c0pperdragon/OS816/doc/breadboard.jpg

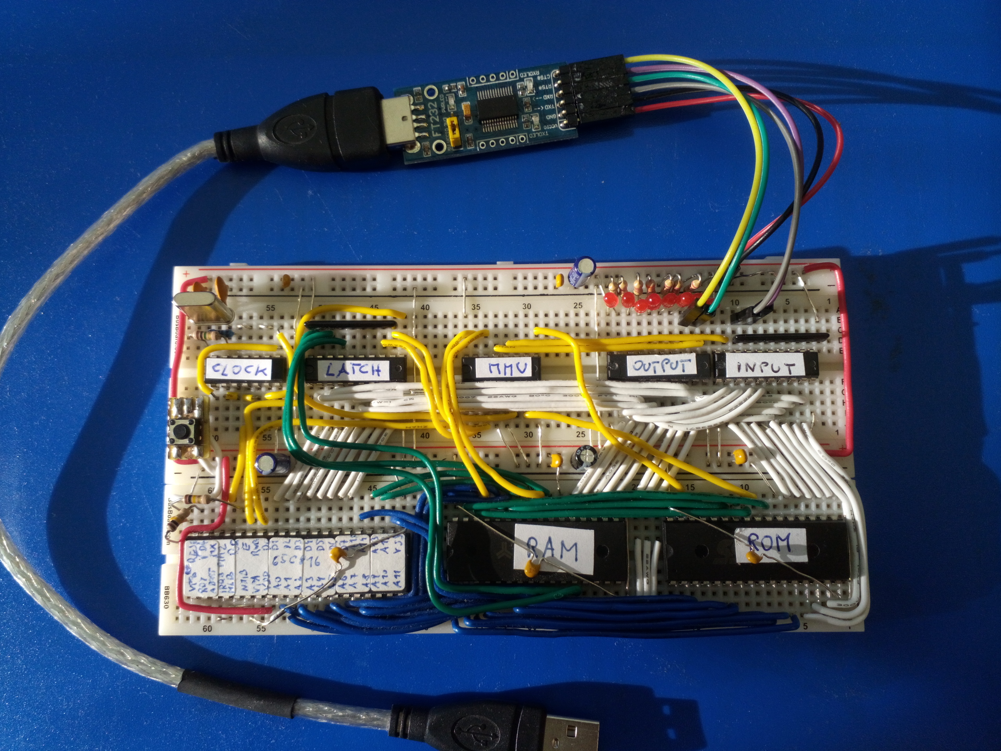
doc/breadboard.jpg
