c0pperdragon/OS816/(threads)

Thread 1 (2022-02-18):

Feature queries: VIA and strobes

gadyke, 2022-02-18:
Really impressed by the approach on this board and how elegant the approach to the limitations/quirks of the chip are. I had a couple of thoughts on apparently missing pieces that I'd welcome thoughts on:

- The design exposes input and output discrete from one another, which makes readback on e.g. a primarily write-only device with a status register. I could probably work around that with a bit of logic to prevent a bus clash (perhaps an input select register?)
- The bus pins don't expose any of the r/w strobes, which makes working with external chips that depend on a data valid/write strobe (or for that matter chip select) more challenging. I could probably break the basic i/owr signal out myself in a fork but it'd good to know if there's a fundamental barrier to that you'd previously considered.
- This in turn doesn't help with external chips that have multiple registers (e.g. 8 bit sound chips) as we don't expose any "address" pins and arbitrary i/o memory mapping would seem quite a headache. So my final question is whether mapping in a 6522 (VIA) to help expand the data/address capabilities would be fundamentally incompatible?

Very happy to be kept honest on all of this!

Thanks,

Greg

c0pperdragon, 2022-02-18:
It seems that you are extremely lucky in this respect.
The OS816 memory space is divided into 4 parts that are addressed by the address bits A23 and A22:
00 = RAM
01 = I/O
10 = unused
11 = FLASH

With the 3rd block unused (addresses 80000 - BFFFF), you can easily map the VIA chip into this range.
Even better, the VIA has two chip select lines which you can directly connect to A23 and A22 to properly select the chip.
As the VIA is specifically designed to work with the signals from the 65c02 and 65c816, you only need to wire up the clock and the RWB signal directly.

When you want to use an existing OS816 board, you will need to tap into the address and data bus and the control signals as well. Unluckily, there is no single chip that has all signals (even the CPU does not provide A23 and A23, as these are outputs of the latch). Your best  approuch would be to solder wires to the underside of the relevant sockets.

When you design your own board, or use a breadboard, you are of course completey free.

HeathenUK, 2022-02-20:
(Apologies for the confusion, switching out of the other account which is otherwise inactive)

Thanks for getting back to me.

I'm looking to adapt your design for my own PCB so as you say wiring to the A22/23 decoded signals is no trouble.

I'm pondering the fact that I don't need to use the '138 in order to add the VIA to the design (since, as you say, it understands the RWB signal just fine) and then adding on my thought above about adding at least one other built-in peripheral to the design (which will need a write strobe), do you see any flaw in:

1. Rather than wiring the VIA up to the A22/A23, wiring its CE pins to two of the unused A19/A20/A21 pins. As before, relying on the RWB signal direct from the 816; and
2. Instead and in addition to wiring the VIA to the unused address pins, using the spare A22/A23 decode on the '138 to add a new read/write strobe combo hooked up to the peripheral IC (which would then be addressable at 0x800000 as above).

I don't see how there could be a problem with (2), but I'm trying to work through in my mind whether under (1) the VIA would clash with the '138 decode logic for the RAM since the RAM rd/wr strobes would (I think) fire during any read/write to the lower address bits as this would leave A23/22 at 0/0.

Thanks again,

Greg

c0pperdragon, 2022-02-20:
You are quite right. Approach 1 would definitely cause a bus conflict with the RAM on any read access.

When you already use a VIA, you will probably not need the simple I/O circuit anyway, so the address space at 40000 is then free for your additional peripherial.
With this proper (read: expensive) solution you could even start to utilize interrupts.

HeathenUK, 2022-02-20:
Thanks for running the thought experiment with me!

I have a couple of follow-up thoughts if you don't mind:

1. I assume there's no issue with tying the same clock to the VIA as the 816? I'm still getting my head around the A16-23/Data multiplexing and exactly when different states will be valid at different points in the instruction cycles. I think it's probably fine as the '573 will have latched at the end of the previous cycle (via #CLK) to the one clocking the VIA (next CLK). The only thing that gives me pause is that the '138 decodes on CLKFAST.

2. Am I correct in thinking that the full range of lower address bits are available to any device strobing on A23/A22 at 1/0 (i.e. replacing the single I/O port address)? That is to say, if my peripheral exposes a few register address pins (rather than just a data bus and a write pin) there's no reason this would clash at all with RAM in the way option 1 above would have done?

And way ahead of you on interrupts! I fully intend to use the timer on the VIA so will indeed hook up IRQB (I'll leave NMI pinned high).

Regards,

Greg

c0pperdragon, 2022-02-20:
The bus timing is indeed a bit tricky with this processor.
Every clock cycle is divided into two halves. The cycle starts when the clock line goes low. There the CPU will put the high address bits on the data bus and the low address bits on the address bus (and also sets RWB according to the access type). In the second half of the cycle (clock high), the CPU will still keep the low address bits on the address buts, but will either release the data bus (for read accesses) or put the outging data there (for write accesses).

A peripherical chip that needs to work with this protocol, also has to tri-state the data bus in the first halve of the cycle even if otherwise selected for read. The VIA (at least the variant from Western Design Center) already does that. With the 138 wired up as in my design, the RW and WR strobes are also idle in the first half of the cycle, so this should work  with all parts that follow the standard RAM access protocol.

My clocking circuit generates this CLKFAST signal to have something that is approx 10ns early in respect to the cpu clock. This should about match the delay introduced by the CPU itself to tweak the performance a tiny bit. With this arrangement I can run the machine with about 14MHz quite reliably. Otherwise there is no real benefit in that.

c0pperdragon, 2022-02-21:
Maybe there is one thing to mention about latching the high address bits: The latch used here is a transparent latch. That means it will change its output signals immediately upon change of the input signals, as long as the latch enable is active. Once the latch enable goes to inactive, the output stays as it was  (maybe I have mixed up the active/inactive nomenclature here).
So contrary to an edge-triggered flip-flop the data does not have to be prepared in the previous cycle but can be delivered relatively late during the cycle.

c0pperdragon, 2022-02-26:
I really would not recommend to having overlapping address ranges. A programming error could cause a bus conflict and potential damage.

But with two MMUs, you can actually do much better:
First MMU:
  Use CLKFAST/A23/A22 as enable signals and A21/A20/RWB as output selectors.
  This gives you access to 4 R/W pairs mapped at 000000-0FFFFF, 100000-1FFFFF, 200000-2FFFFF, 300000-3FFFFF
Second MMU:
  Use CLKFAST#/A23 as enable signals (the A23 connects to the active-high enable, and you need to take CLKFAST# from U5A).
  Use A22/21/RWB as output selectors
  This gives 4 R/W pairs mapped at 800000-9FFFFF, A00000-BFFFFF, C00000-DFFFFF, E00000-FFFFFF
This leaves the area 400000-7FFFFF free so you can map in the VIA

HeathenUK, 2022-02-26:
Hmm, thanks. Can I ask a couple of questions?

- Can you explain the reasoning behind the change to clkfast# for the second MMU?

- For me the main benefit in my schema was freeing up room for an extra VIA-like device, I think this still leaves just the one unmapped range to tie a VIA into and therefore no more to map a second VIA-like device in. Have I misunderstood?

- I'm also not sure I see the address overlap I've created in that schematic - but I think that's a basic error on my part if you could point it out?

c0pperdragon, 2022-02-27:
To clarify my proposal, I just explain what the E1 - E3 inputs of the MMU are actually doing: In order for any output to be active (low), all of the enable inputs need to be in their active state. That means E1,E2 low and E3 high.
In my original OS816 i just use the active high input to enable the RD/WR signals only in the second half of the clock cycle.
I could also have used one of the other enable inputs, by feeding in the inverted CLKFAST signal. But my measurements showed that by using just the CLKFAST all signals timings matched up better.

In my proposal I would feed A23,A23 to E1,E2 and CLKFAST to E3 (as original) of the frist MMU.
The second MMU needs to be active on a high A23. As there is only one active-high enable input available I just swapped the polarity of the CLK as described above so I can use a low-active enable for this.

The address overlap in your schematic is for the range 100000-3FFFFF. Performing a read on these addresses would select both RAMRD#, as well as one of IORD#, AUDIORD, SPARERD.

c0pperdragon, 2022-02-27:
Maybe I could propose another solution that uses only one MMU but a bit of additional decoding logic.
This solution would give you 4 RD/WR pairs and also the possibility to map in some VIA-style chips.
Additionally  the memory addresses as used in the OS816 software would stay the same, so there is no need to modify it.

Starting from the original OS816 schematics, you can use some logic gates (preferable from a single chip) to create a single signal from A23,A22,A21.  This signal can be high when the address does not match one of the ranges needed by the OS816 system. Use this signal as active high CS input to the VIA-type chips (more decode logic may be necessary, depending on the IC). Also use this signal as one of the active-low enable inputs for the MMU.

For example, using a single 7400 ICs, you can combine this to NOT ((A23 NAND A22) NAND A21) . If I am correct, this would create a high signal for the ranges 200000-3FFFFF, 600000-7FFFFF, A00000-BFFFFF.

HeathenUK, 2022-02-27:
On your first response - I see! I thought there was some timing reason for using CLKFAST#, it didn't even occur to me that it was because you'd used up the active-high enables.

I think I more or less got to your reasoning in the end as I tabled out the implications for the two '138s...

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

Clearly there's room for flash etc. but the range will be completely different as you say.

Greg

HeathenUK, 2022-02-27:
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

On this second response, wouldn't this mean that each of the VIA-type devices mapped in directly would have their CE go high when any of the others was accessed? Or is the suggestion that (since most VIA-type chips have two CE pins) you would also tie a unique address pin to the other CE pin?

HeathenUK, 2022-02-27:
I've also just realised that nothing at all bars us from bumping flash and RAM up to 8mbit (other than the fact that it's overkill!) but I don't think that's unique to the dual MMU proposal.

HeathenUK, 2022-02-27:
As an aside I've just been skimming the monitor/bios code to see how involved it's going to be if I end up needing to change ranges around.

I assume I need to leave RAM at 00:0000, and also assume it's necessary (for vectors) to leave FLASH at the other end, which in this new arrangement becomes E0:0000 to FF:FFFF. For the latter I assume I need to adjust both the x_topaddress routines and the linker parameters in build.bat. Have I got that right? I'm finding the assembler/linker/librarian docs a bit obtuse!

Regards,

Greg

c0pperdragon, 2022-03-01:
Yes, it is necessary that RAM is visible at 00:0000.
FLASH indeed needs to be at the high end because my simple circuit forces the bank address to FF during emulation mode after startup. You can change this by weakly pulling some address pins low instead of high, but you would need additonal resistors instead of my simple solution with the single resistor pack.
The rest is open to rearrangement, but you may have to do changes to the code.

If you are re-arranging things anyway and use a second MMU, you could as well expand the addressing capabilties like this:
First MMU like in my prosoal for address ranges 0x:xxxx, 1x:xxxx, 2x:xxx, 3x:xxxx
Second MMU simimlar, but for the ranges Cx:xxxx, Dx:xxxx, Ex:xxxx, Fx:xxxx
This completely leaves two big ranges (400000-7FFFFF and 80000-BFFFFF) that can be used for two VIA-style components.
The only drawback is that you need to invert at least one of the address lines A23,A22 to use as enable inputs for the second MMU. If you need a 74HC04 anyway, you could as well invert both and feed the CLKFAST into E3 as usual.

I don't have the details on the linker commands in my head right now. You may need to experiment to get things right.

gadyke, 2022-03-01:
I like that, the obsessive in me prefers the evenness of having 8 1Mbyte address ranges rather than 4 1Mbyte and 4 2Mbyte!

c0pperdragon, 2022-03-01:
I just looked at the clock circuit in the OS816 schematic. Maybe you can just re-arrange the inverters a bit to free one up to invert A23. Together with the trick to use CLKFAST# instead of CLKFAST you could get away without the need for an additional 74HC04.

c0pperdragon, 2022-03-01:
Yes, U5E should not be all too important for the clock signals shape.

gadyke, 2022-03-01:
Great, this is looking more and more elegant a solution every moment!

gadyke, 2022-03-02:
Almost a philosophical question from me on the consequence of cutting out one of the existing post-crystal inverters...

Strictly speaking that would mean CLK would now be CLK#, CLKFAST will be CLKFAST# and vice versa. I suppose in practice it makes absolutely no difference - a square wave is a square wave even when it's inverted.

Basically I was wondering if I need to do any rewiring of the various uses of those signals and came to the conclusion that it's irrelevant!

Any correction on that?

Greg

c0pperdragon, 2022-03-02:
Yes, inserting/removing an inverter there makes no difference. I actually no not consider the signal from the crystal of being any  specific phase until it is used for some useful logic. From this point on, of couse you need to name the things properly.

If couse you can wire up the various gates in the logic ICs as is most convenient for you.

I myself normally adjust the use of gates during the board layout to keep things as disentangled as possible.

gadyke, 2022-03-02:
Great, I'll re-do the schema tonight before I get started on laying out a board.

G

HeathenUK, 2022-03-04:
Right, this all looks good to me - would you be willing to skim and see if anything looks obviously wrong on the MMU side?

[mainboard_MMU2.pdf](https://github.com/c0pperdragon/OS816/files/8188273/mainboard_MMU2.pdf)

That schematic is based around this mapping out:

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

I think I'll source an 8mbit SRAM just because it can fit, 8mbit parallel NOR sadly rarer 🤣

G

c0pperdragon, 2022-03-04:
Looks OK to me. With this setup you can use a RAM IC with up to 1MB, as you said. What kind of parts to you intend to use? As far as I know, there are no through-hole parts with this size available.

HeathenUK, 2022-03-04:
Thanks and you're absolutely right - I'm happy enough soldering SMD components where I won't have cause to swap them on and off so I'm using a TSOP44 part.

Leaving the flash as PLCC though!

G

c0pperdragon, 2022-03-17:
Maybe it is a little late now, but I actually found the perfect solution to add auxilary ICs to the OS816 architecture without modifying the original memory map, so there is no need to modify the BIOS:

* Start from the original OS816 schematic.
* Fully wire up the latch to the data bus (which I should have done in the first place anyway)
* Add one 74HC138 (call it MMU2)

The MMU2 has its E2/E3 connected to A23/A22 so it is active only for the free range 800000-BFFFFF
The A0-A2 inputs of the MMU2 are connected to A19-A21.
This gives you 8 chip-select (CS) outputs what will be active (low) for the 8 individual ranges 800000-87FFFF,880000-8FFFFF,...

Each CS can be used to either drive a VIA-style IC (together with system clock and RWB), or to drive a memory-style IC (together with the previously unused output pins 10 and 11 of MMU1 as its RD and WR lines)

HeathenUK, 2022-03-17:
So in this schema MMU1 gives you (as before) 8080-style ranges with a RD# and WR# for each range, while MMU2 gives you 8  "traditional" CS# pins.

The only downside I can see is that I was getting used to the idea of having 1MB of SRAM 😄

c0pperdragon, 2022-03-18:
Yes, that is right. You get 3 RW#/WR# ranges (4 MB each) and 8 ranges for the CS# pins. (512KB each).
And the 4th R/W pair generates the access signals if they are needed for any IC that sits on one of the CS# ranges. Your sound chip for example would be connected to one CS line and to these R/W as well.

gadyke, 2022-03-18:
Ok great, can I check that you actually meant E2/E3 as A22/A23 rather than A23/A22 for MMU2 if you're targeting the unusued 80:0000-BF:FFFF range (since E2 is the active low)?

Just to make sure I haven't missed something. I'll probably table it out again anyway later just to get the ranges noted down.

G

c0pperdragon, 2022-03-18:
Yes, I mixed that up. E3 (active high) gets A23 and one of E2/E1 (active low) gets A22. The remaining is just GND.

gadyke, 2022-03-18:
Ah good.

This seems perfect, and the most elegant solution so far - as you say it doesn't need any changes to the existing map (though agree with your thinking in Issue #3 that opportunities to make the ranges dynamic are sensible!)

G

HeathenUK, 2022-03-28:
Just as a coda to this discussion and in case you're curious, this is the schematic I'm currently routing: [mainboard_MMU2.pdf](https://github.com/c0pperdragon/OS816/files/8361207/mainboard_MMU2.pdf)

Thread 3 (2022-03-17):

BIOS support for more RAM

c0pperdragon, 2022-03-17:
The OS816 memory architecture allows for fairly easy extension of the RAM to up to 4MB in a modified circuitry. This can easily be done by using a larger static RAM IC.
But currently there is no direct support from the standard BIOS. There is actually a function call to query the size of the RAM, but this is currently hardcoded to just report 512K.

@gadyke @HeathenUK
If there is demand for that, I could modify the BIOS code to add some auto-detection to see how much RAM is actually installed and then report his number on the existing bios function call. This would immediately allow user programs to access more dynamic RAM via the malloc/free memory management.

gadyke, 2022-03-17:
That would be amazing!

I've actually just started to make a list of all the references/constants I will need to update to account for the new memory map and ranges (including, for example, the RAM size function call).

I was also thinking about changing some of the hard coded constants (e.g. for flash location, length) into labels/references so I can define the values at the top of the source rather than mid-file (and sometimes more than once).

Greg

gadyke, 2022-03-18:
This might be for Issue 1 where we're discussing memory maps, but when you say 4MB SRAM is supported "in a modified circuitry" do you just mean fully wiring up MMU1?

I ask because I think that in every other way you've already got a 4MB address space per-device in MMU1.

c0pperdragon, 2022-03-18:
Yes, I meant just that, as the current reference schematics does not provide A19-A21

gadyke, 2022-03-18:
Ah right, understood! Apologies for any confusion, I responded above to your original thought.

c0pperdragon, 2022-03-18:
I have just uploaded a new revision of the main board sematics and layout + gerbers. It was actually embarasingly easy to add the traces to the PCB layout. I really don't know why I left them out in revision 3.
This now makes the board much more "hackable" if anyone wants to solder additional parts to it.

c0pperdragon, 2022-03-19:
The modifications to the bios are done and available in the github releases section.
Autodetection will work for RAM sizes of 512KB, 1MB, 2MB, 4MB.  The detection algorithm assumes that the RAM is always visible in the whole range of 000000 - 3FFFFF. With ICs smaller than 4MB, the same memory locations are visible in the usual repeating pattern.

gadyke, 2022-03-21:
This is just about related, but I've been thinking about how I intend to lay out the RAM for the board and although 32Mbit SRAM does exist it's expensive (and always SMD, not that that's an issue).

I don't see any design reason why I can't just decode A20 and A21 (either via a '138 with a fixed input or a '139) and spread the RAM over 4 much cheaper 8Mbit chips (using the decoded address as a RAM chip-specific CS#), relying on the pre-existing RAMRD# and RAMWR# signals.

It seems a pretty standard design choice (it's what Sergey did with the Omega), but please do scream if there's some OS816-specific reason this would be a bad idea!

G

c0pperdragon, 2022-03-22:
Using 2 ICs to get 4 MByte in total would also have been my choice.
But you probably need to invert A21 for one of the chips. You can again free up one inverter as discussed earlier.
Or maybe you can get a RAM IC that has two CS inputs (one low-active and one high-active). I remember that once I saw such an arrangement on a 64Kbyte RAM.

gadyke, 2022-03-22:
Yep that's exactly what I was thinking, most of the 2MByte ICs I've found have both a high and a low CS, including one of the bigger brother of the 1MByte IC you're already using (AS6C1608)!

And yeah if that doesn't work I can re-purpose an inverter again as you say.

G

c0pperdragon, 2022-03-22:
I did a quick check on mouser and it seems that there are no parts bigger than 1MByte that run on 5V. So if you want to have 4MB and no voltage translation (which is is real pain, actually), you need 4 ICs.
On the other hand, if you are content with 2MB this is totally easy as these ICs do have CS# and CS2 inputs.
With 4 parts, address decoding is a bit more complicated and would need at least 2 inverters for A21 and A20.

gadyke, 2022-03-22:
You're quite right - something I haven't had cause to mention is that I'm planning to run the board on 3.3V (bucked down from a 5V lipo charge/boost board) with a few components powered from the master 5V supply but all **logic** done on 3.3V.

Do shout if there's some obvious reason that wouldn't work - it all seems to be within spec for the W65c816S (I may have to keep to 10-14MHz though).

G

gadyke, 2022-03-22:
Yeah I'd be doing the same (and would stick as you say with 4 ICs for RAM decoded via a '138/139), but my grand plan is for this to become a portable device - I'm going to mount a 7" LCD to the PCB driven by an RA8876 (a chip that has roughly the same level of hardware acceleration as a contemporary VDP and plenty of VRAM).

All the I/O on that LCD driver board is 3.3v so although I could translate the voltage back to 5V it's a *lot* of lines to translate (~25) and switching to 3.3V overall opens the door to a bunch of other ICs.

G

gadyke, 2022-03-22:
I'm also hoping that if I can get my routing and decoupling right and switch to a 4 layer board I might be able to push a 3.3V version to 16MHz without too much effort, but there's a reason I'm making it possible to change out the crystal!

Thread 4 (2022-04-16):

Incorrect A14, A15 and A17?

HeathenUK, 2022-04-16:
I was just glancing at your original schematic and PCB routing when sense checking my own design and realised that you seem to have A15 wired to A17, A17 to A14 and A15 to A14. As far as I understand the design this shouldn't be intentional but equally may not have shown up given how high up the RAM addresses it occurs?

c0pperdragon, 2022-04-16:
I changed the wiring to get a simpler board layout. When you think about it, it makes absolutely no difference how you wire up the address pins on a static ram.Same holds true for the data pins.

HeathenUK, 2022-04-16:
I did wonder about that, I guess you're right as long as it's consistent throughout runtime - it feels like sacrilege though!

Closed 2022-04-16.
