c0pperdragon/OS816/ramboard/ramboard.pdf

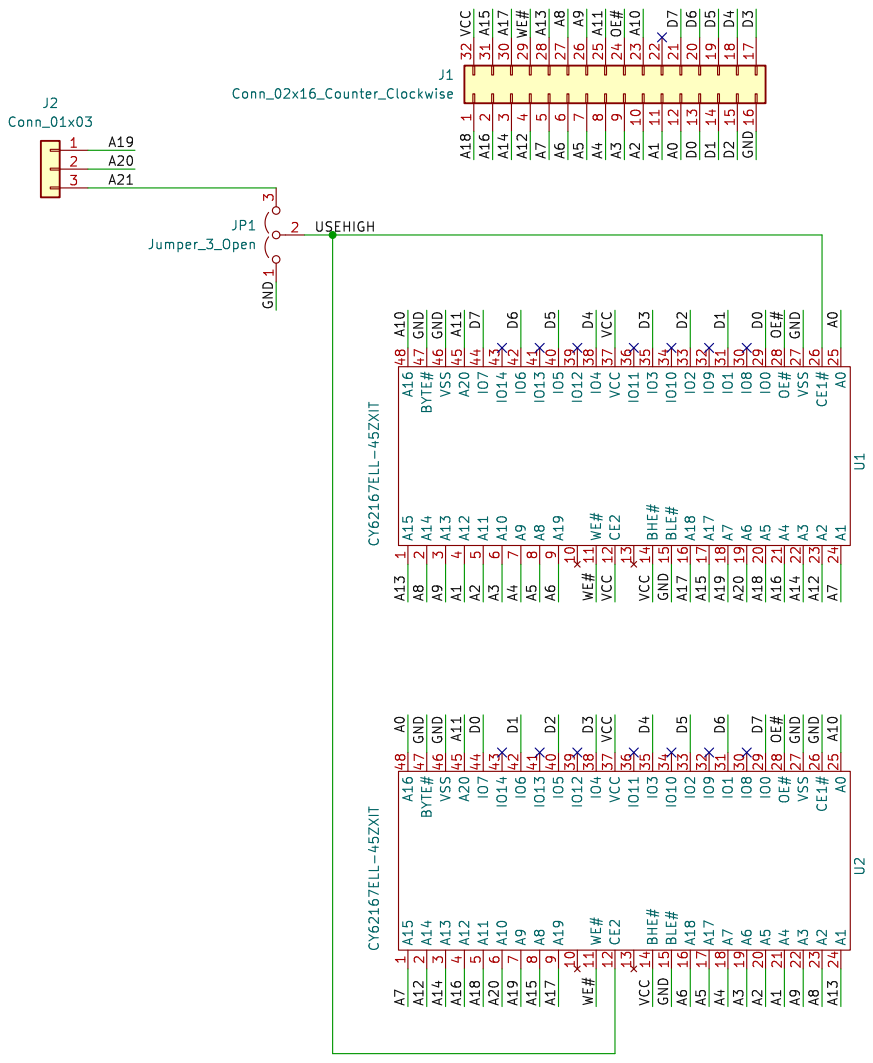
[picture p60: page 1]

Id: 1/1 Title: OS816 RAM board
