c0pperdragon/OS816/mainboard/mainboard.pdf

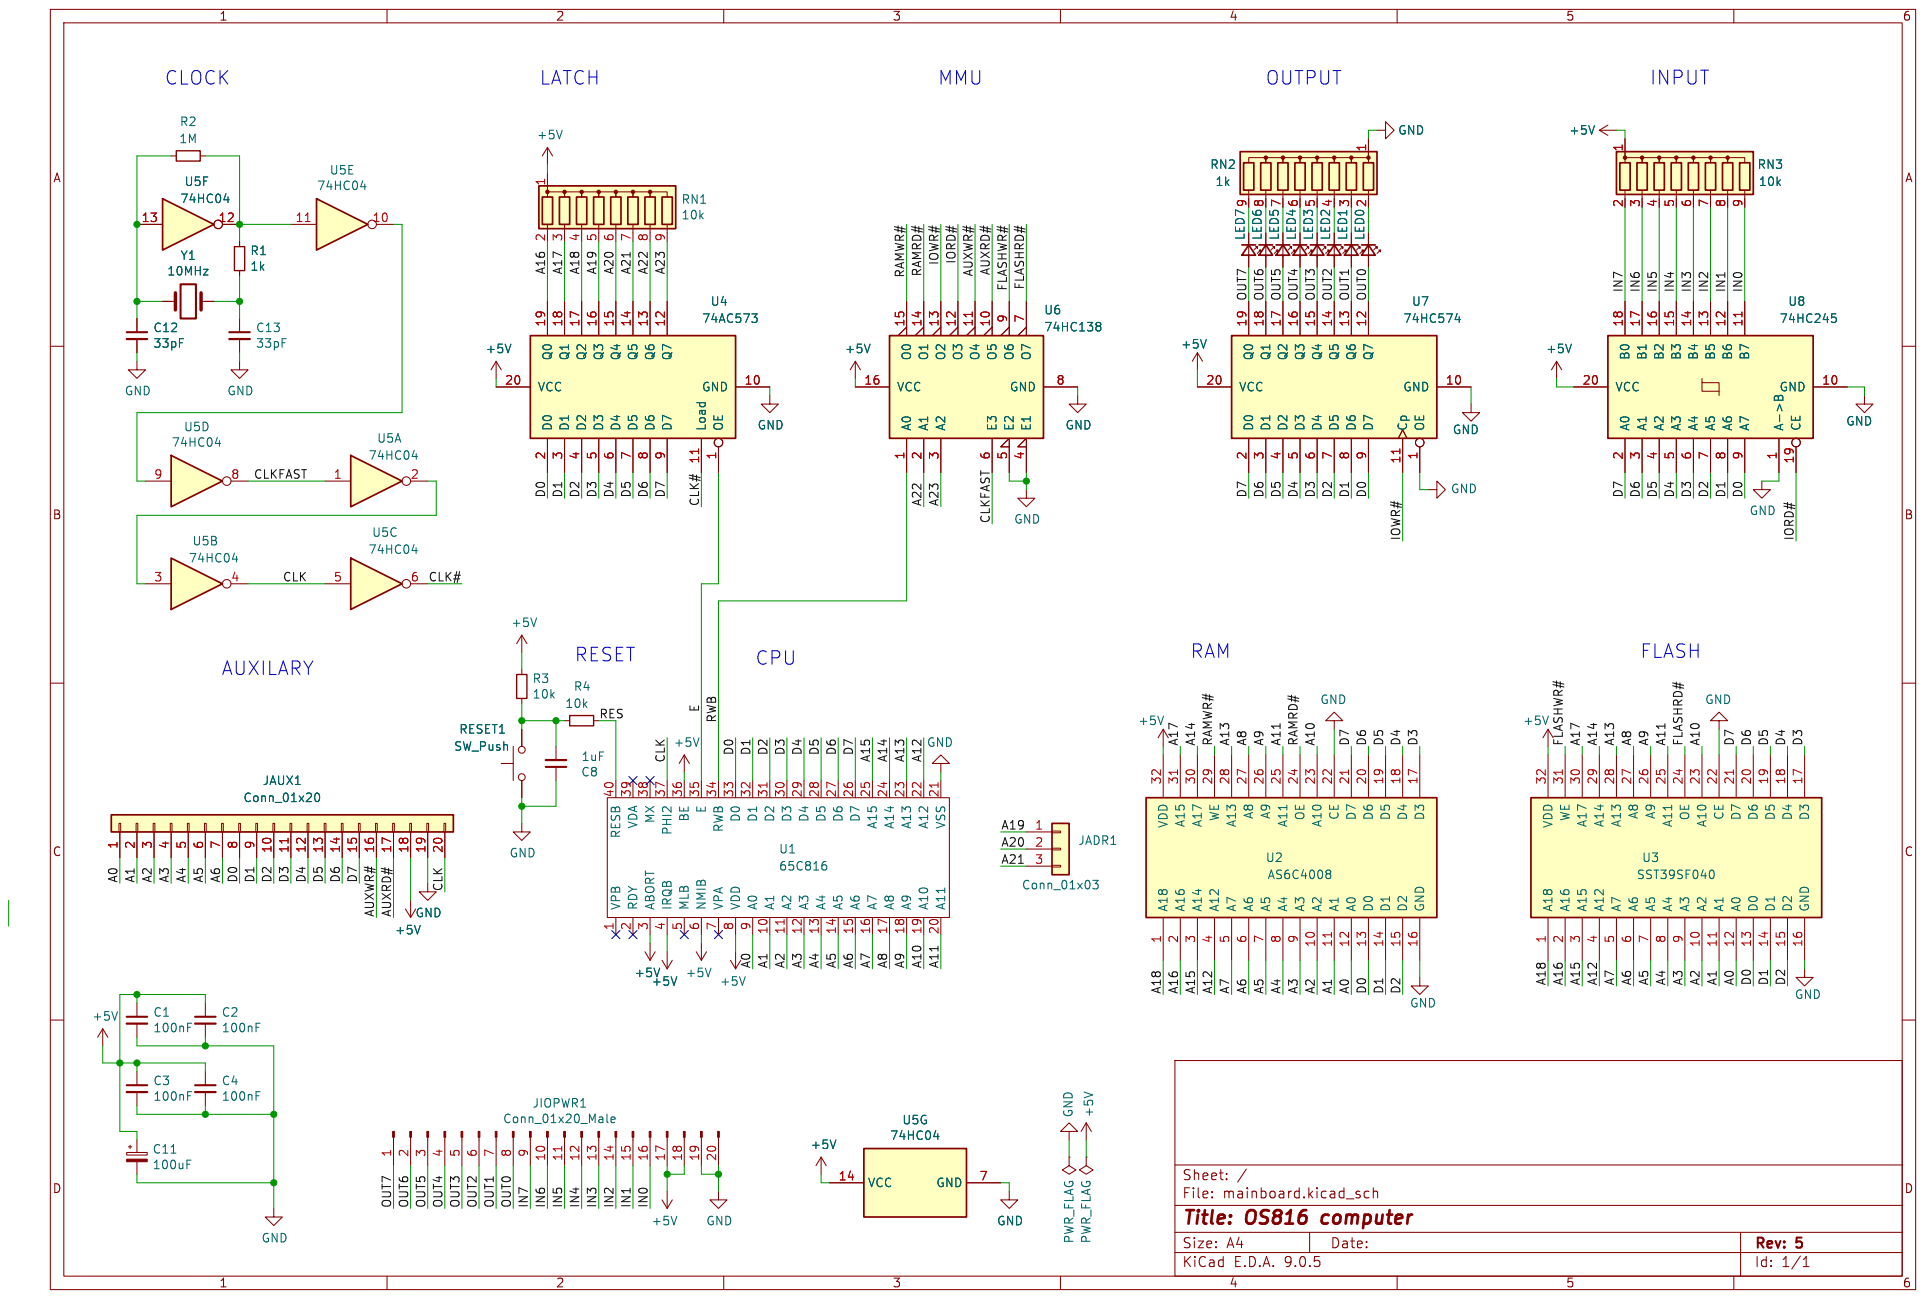
[picture p61: page 1]

9 A2 10 A1 11 A0 12 D0 13 D1 14 D2 15 GND 16 VDD 32 WE 31 A17 30 A14 29 A13 28 A8 27 A9 26 A11 25 OE 24 A10 23 CE 22 D7 21 D6 20 D5 19 D4 18 D3 17 U3 SST39SF040 C4
JAUX1 Conn_01x20

9 A1 10 A2 11 A3 12 A4 13 A5 14 A6 15 A7 16 A8 17 A9 18 A10 19 A11 20 RESB 40 VDA 39 MX 38 PHI2 37 BE 36 E 35 RWB 34 D0 33 D1 32 D2 31 D3 30 D4 29 D5 28 D6 27 D7 26 A15 25 A14 24 A13 23 A12 22 VSS 21 U1

9 A2 10 A1 11 A0 12 D0 13 D1 14 D2 15 GND 16 VDD 32 A15 31 A17 30 WE 29 A13 28 A8 27 A9 26 A11 25 OE 24 A10 23 CE 22 D7 21 D6 20 D5 19 D4 18 D3 17 U2AS6C4008 VCC 14 GND 7 U5G
