c0pperdragon/OS816/src/os816.asm

    ; external references
    XREF _ROM_BEG_DATA
    XREF _BEG_DATA
    XREF _END_DATA
    XREF _BEG_UDATA
    XREF _END_UDATA
    XREF ~~main
	
    ; linking to bootloader code
    xdef ~~softreset
    xdef ~~sleep
    xdef ~~send
    xdef ~~receive
	xdef ~~sendstr
    xdef ~~writeflash
    xdef ~~eraseflash
    xdef ~~topaddress_flash
    xdef ~~topaddress_ram
    xdef ~~sendnum
    xdef ~~portout
    xdef ~~portin
~~softreset        set $FFF000
~~sleep            set $FFF003
~~send             set $FFF006
~~receive          set $FFF009
~~sendstr          set $FFF00C
~~writeflash       set $FFF00F
~~eraseflash       set $FFF012
~~topaddress_flash set $FFF015
~~topaddress_ram   set $FFF018
~~sendnum          set $FFF01B
~~portout          set $FFF01E
~~portin           set $FFF021

    ; start vector on fixed address        
LAUNCH SECTION
    ORG $C00000
    JMP >startmain
    ENDS
        
    ; startup code already in CODE segment
    CODE
startmain:
    LONGA ON
    LONGI ON

    ; clear UDATA segment
    LDA #_END_UDATA-_BEG_UDATA ; number of bytes to clear
    BEQ noclear    
    SEP #$20     ; for 8-bit memory access
    LONGA OFF
    LDA #0
    STA >_BEG_UDATA
    REP #$20  
    LONGA ON
    LDA #_END_UDATA-_BEG_UDATA-1 ; number of bytes to replicate
    BEQ noclear
    LDX #<_BEG_UDATA  
    TXY   ; set up copy instruction for forward replication
    INY
    DEA  
    MVN #^_BEG_UDATA,#^_BEG_UDATA
noclear:

    ; Copy initial content into DATA segment. 
    ; Also the Data Bank Register will be correctly set to this bank  
    ; by the MVN instruction    
    LDA #_END_DATA-_BEG_DATA ;number of bytes to copy
    BEQ nocopy
    DEC A ;less one for MVN instruction
    LDX #<_ROM_BEG_DATA ;get source into X
    LDY #<_BEG_DATA ;get dest into Y
    MVN #^_ROM_BEG_DATA,#^_BEG_DATA ;copy bytes
nocopy:

    ; to work around in a bug in the sprintf function, leave a portion 
    ; of the stack unused 
    TSC
    SEC
    SBC #768
    TCS
	
    ; start the main function
    PEA #^argv
    PEA #<argv    
    PEA #1
    JSL >~~main
    
    ; do proper exit handling
    PHA
    JSL ~~_exit

progname:
    DB "OS816"
    DB 0
argv:
    DW #<progname
    DW #^progname
    DW 0
    DW 0
    ENDS 


    xdef ~~_exit    
    CODE
~~_exit:
; ------------------ RESTART or SHUTDOWN --------------------
; Let the machine restart or stop entirely 
; This depends on the exit-value. All negative values will cause a complete stop. 
    ; initial stack layout:  
    ;   SP+1, SP+2, SP+3    return address
    ;   SP+4, SP+5          return value from main() or exit()
    LDA <4,S
    BPL wantreset
    STP
wantreset:
    JMP >~~softreset    
    ENDS
	
    
    END
