c0pperdragon/OS816/src/boot.asm

; -------------- interface with boot monitor program ------------
    XREF ~~monitor
    XDEF ~~send
    XDEF ~~receive
    XDEF ~~sendstr
    XDEF ~~writeflash
    XDEF ~~eraseflash
    
    
; --------------------- RAM layout ---------------------------- 
stacktop            set $00FEFF   ; right below the reserved 256 bytes
buffereddata        set $00FF00   ; 252 bytes
numbuffered         set $00FFFC   ; 8 bit
numconsumed         set $00FFFD   ; 8 bit
outportshadow       set $00FFFE   ; 8 bit
detectedrambanks    set $00FFFF   ; 8 bit

; The timeouts for waiting for incomming data after asserting RTS and then also after
; de-asserting the line again. 
; For true 65c816:
;    One timeout unit is 17 clocks, so a receive function call will
;    cause an idle delay of about 500 microseconds.
timeout1             set 194
timeout2             set 100
; For Bernd emulation use same values, even if the timeout would be higher than necessary

BOOT SECTION        ; needs to be located at $FFF000
    LONGA ON
    LONGI ON
    
; ------------ JUMP TABLE INTO THE BOOT LOADER ROUTINES ---------    
    JMP ~~softreset            ; FFF000
    JMP ~~sleep                ; FFF003
    JMP ~~send                 ; FFF006 
    JMP ~~receive              ; FFF009
    JMP ~~sendstr              ; FFF00C 
    JMP ~~writeflash           ; FFF00F
    JMP ~~eraseflash           ; FFF012
    JMP ~~topaddress_flash     ; FFF015
    JMP ~~topaddress_ram       ; FFF018
    JMP ~~sendnum              ; FFF01B
    JMP ~~portout              ; FFF01E
    JMP ~~portin               ; FFF021

; -------------------- STARTUP -------------------------------
~~softreset
    ; 16-bit mode for accu and index registers
    ; clear all other status flags as well
    REP #$FF   
   
    SEP #$20 
    LONGA OFF
    ; detect number of RAM banks
    LDA #64        ; possibly 4MB
    STA >$3FFFFF
    LDA #32        ; possibly 2MB
    STA >$1FFFFF
    LDA #16        ; possibly 1MB
    STA >$0FFFFF
    LDA #8         ; possibly 512KB
    STA >$07FFFF   
    LDA >$3FFFFF   ; read out result of detection
    STA >detectedrambanks
    ; set the output port to a defined state
    LDA #$FF
    STA >$400000
    STA >outportshadow
    REP #$20 
    LONGA ON
            
    ; initial stack pointer
    LDA #stacktop
    TCS 
    ; initial direct pointer  = 0
    LDA #0
    TCD

    ; clear initial serial communication buffer and variables 
    ; and also init data bank register on the way
    LDA #0
    STA >buffereddata
    LDX #buffereddata
    LDY #buffereddata+1
    LDA #252
    MVN #^buffereddata,#^buffereddata ;clear-copy bytes
    
    ; for genuine 65c816 add a small delay to stay clear of 
    ; potential double resets at power up
    CLC
    XCE 
    BCS skipstartupdelay
    PEA #100
    JSL >~~sleep
skipstartupdelay

    ; when there is no user program at all directly go to monitor
    LDA >$C00000
    CMP #$FFFF
    BEQ startmonitor
    ; check incomming CTS signal to detect if there is a communication partner
    ; present to receive start message and to maybe trigger boot monitor
    SEP #$20 
    LDA >$400000
    REP #$20    
    AND #$0040
    BNE startuserprogram
    PEA #^startupmessage
    PEA #<startupmessage
    JSL >~~sendstr
    ; give some time to press key to enter monitor 
    PEA #1000
    JSL >~~sleep
    ; check if some key was pressed in the meantime
    JSL >~~receive
    CMP #0
    BMI startuserprogram
startmonitor
    JSL >~~monitor
    ; when there is a user program available then, fire it up
    LDA >$C00000
    CMP #$FFFF
    BEQ startmonitor
startuserprogram
    JSL >$C00000
    BRL ~~softreset

startupmessage
    DB "OS816 1.4 - press any key to enter monitor."
    DB 13,10,0
    
    
; ----------------- Tuned delay loop ----------------------
~~sleep
    ; initial stack layout:  
    ;   SP+1, SP+2, SP+3    return address
    ;   SP+4, SP+5          16-bit parameter: milliseconds
    
    ; this loop is fine-tuned to take 10000 clocks per iteration
    ; (one-time method call overhead can not be avoided) 
    LDY #1998    
    ; check if the code is running on a true 65c816 - use cycle-exact timing
    CLC
    XCE 
    BCC delayloop
    ; emulated by Bernd. use different delays for this (tuned by measurement)
    LDY #190
delayloop
    LDA 4,S   
    BEQ done
continue
    TYX              ; 2 cycles
    TYX              ; 2 cycles
    TYX              ; 2 cycles
continue2
    DEX              ;   2 cycles
    BNE continue2    ;   2 or 3 (if taken) cycles
    DEC              ; 2 cycles
    BNE continue     ; 2 or 3 (if taken) cycles
done                ; SUM = 2+2+2 + (2+3)*1998 - 1 + 2 + 3 = 10000                     
    ; take down parameters, fix return address and return
    LDA 2,S
    STA 4,S
    PLA 
    STA 1,S
    RTL
    
; ----------------- Serial communication ------------------    
; Serial communication via the generic input and output ports.
; In order to not need any form of expernal uart receiver, hardware flow control
; via a CTS/RTS handshake is applied. With this the CPU only needs to handle input
; when it is actually prepared for it.
; Communication is done one start bit, one stop bit, no parity.
; When running on genuine 65C816, the speed is 115200 baud.
; On Bernd the speed is clocked down to 9600 baud.

; Pin assignments:
;   TX    Output bit 0
;   RX    Input bit 7
;   RTS   Output bit 1
;   CTS   Input bit 6
; All other output pins are just set high when the serial communcation is running, and
; are left high after that. 

    ; -- send one byte via serial
~~send
    ; initial stack layout:  
    ;   SP+1, SP+2, SP+3    return address
    ;   SP+4, SP+5          data to send (in lower bits only)
    ; save data bank register
    PHB      
    ; switch to 8 bit accu/memory
    SEP #$20 
    longa off
    ; make IO address available via DBR
    LDA #$40
    PHA
    PLB      
    ; must wait until the receiver is ready to accept new data (incomming CTS must be low)
waitforready
    BIT 0
    BVS waitforready
    ; prepare the other output bits for the io port
    LDA >outportshadow
    PHA
    ; send one byte bit by bit (1 start bit, 1 stop bit, no parity)
    LDA 4+2,S
    CLC         
    JSR sendreceivebit ; start bit    6 cycles
    ROR A              ;              2 cycles                
    JSR sendreceivebit ; bit 0
    ROR A       
    JSR sendreceivebit ; bit 1
    ROR A       
    JSR sendreceivebit ; bit 2
    ROR A       
    JSR sendreceivebit ; bit 3
    ROR A       
    JSR sendreceivebit ; bit 4
    ROR A                     
    JSR sendreceivebit ; bit 5
    ROR A              
    JSR sendreceivebit ; bit 6
    ROR A              
    JSR sendreceivebit ; bit 7    
    SEC                ;             2 cycles
    JSR sendreceivebit ; stop bit 
    PLA
    ; switch to 16 bit accu/memory
    REP #$20 
    LONGA ON
    ; restore DBR
    PLB
    ; take down stack and return
    LDA 2,S
    STA 4,S
    PLA 
    STA 1,S
    RTL
  
    ; -- receive one byte via serial
~~receive
    ; save data bank register 
    PHB
    ; switch to 8 bit accu/memory
    LDA #0  ; make sure high byte is 0 from now on, so TAX and TAY work
    SEP #$20 
    longa off
    ; when there is unconsumed data left in buffer, no need to get more
    LDA >numconsumed
    CMP >numbuffered
    BCC donereceive
    ; completely reset buffer
    LDA #0
    STA >numbuffered 
    STA >numconsumed 
    ; prepare accessing the io addresses
    LDA #$40
    PHA
    PLB
    ; notify the sender that we are ready to accept data
    LDA >outportshadow
    AND #$FD      ; set RTS low
    STA 0
    ; Implement an edge-detector with latency jitter as low as possible.
    ; On real CPU the uncertainty is about 9 clocks which is below 0.1 bits
    ; On Bernd the uncertainty is about 150 clocks (12.5us) which is a higher
    ; relative jitter for a 19200 bit/s signal, but maybe OK as well.
state_RTS_active
    CLC           ; carry flag for timeout   
    BIT 0                                   
    BPL startbitdetected                       
    LDA #256-timeout1                        
waitforstartbit
    BIT 0                                    ; 4      (55) 
    BPL startbitdetected                     ; 2      (21)
    ADC #1        ; progress timeout         ; 2      (71)
    BIT 0                                    ; 4      (55)
    BPL startbitdetected                     ; 2  2   (21)
    BCC waitforstartbit                      ; 3      (43)
timeoutreached
    BRA set_RTS_inactive
startbitdetected
    LDA >outportshadow                       ; 5  5
    AND #$FD      ; keep RTS low             ; 2  7
    PHA                                      ; 3  10
    JSR receiveandstorebyte                  ; 6  16
    PLA
    ; when buffer is not too full, keep RTS active
    LDA >numbuffered
    CMP #200
    BNE state_RTS_active
    ; set RTS high
set_RTS_inactive
    LDA >outportshadow
    STA 0
    ; second implementation of the edge-detector. this is used
    ; in the state when RTS is already de-asserted.
    ; Then the sender should stop as soon as possible. but may
    ; send a few more bytes.
state_RTS_inactive
    CLC           ; carry flag for timeout   
    BIT 0                                   
    BPL startbitdetected2                    
    LDA #256-timeout2                          
waitforstartbit2                            
    BIT 0                                   
    BPL startbitdetected2                    
    ADC #1        ; progress timeout         
    BIT 0                                    
    BPL startbitdetected2                    
    BCC waitforstartbit2                     
timeoutreached2
    BRA donereceive
startbitdetected2
    LDA >outportshadow
    PHA
    JSR receiveandstorebyte                  
    PLA
    BRA state_RTS_inactive
    ; after operation, may or may not have data in buffer
    ; when numbuffered > 0, there is something usable
donereceive
    LDY #$FFFF             ; default value for no data
    LDA >numbuffered
    BEQ returnfromreceive  ; when nothing here
    LDA >numconsumed
    TAX
    INC 
    STA >numconsumed       ; progress numconsumed counter
    LDA >buffereddata,X
    LDY #0
    TAY                    ; 0-expand to 16 bit
returnfromreceive
    REP #$20 
    LONGA ON
    TYA
    PLB
    RTL    

    ; Subroutine to fetch a byte of data and store in input buffer
    ; routine will terminate as quickly as possible but only
    ; after input level is inactive (high) again.
    ; With 0 - 9 clocks jitter, need to do the first sampling at
    ; about 126 clocks after the flank of the start bit
receiveandstorebyte  
    LONGA OFF                                            ;    16
    ; add some delay to get the first bit sample point correct
    ; detect underlying hardware
    CLC                                                  ; 2  18
    XCE                                                  ; 2  20
    BCC true65c816_2                       ; branch taken: 3  23
berndemulation_2
    BRA startreceivebyte
true65c816_2
    LDX #2                                               ; 3  26
delay5 
    DEX                                                  ; 2  28 33    
    BNE delay5                                          ; 2/3 31 35 
    NOP                                                  ; 2  37
    NOP                                                  ; 2  39
    NOP                                                  ; 2  41
startreceivebyte
    ; pass down the pattern for other output bits 
    LDA 3,S                                              ; 4  45
    PHA                                                  ; 3  48
    ; prepare outgoing TX bits to be all idle
    LDA #$FF                                             ; 2  50
    SEC                                                  ; 2  52   
    ; transfer
    JSR sendreceivebit ; bit 0                           ; 6+68 126
    ROR A       
    JSR sendreceivebit ; bit 1
    ROR A       
    JSR sendreceivebit ; bit 2
    ROR A       
    JSR sendreceivebit ; bit 3
    ROR A       
    JSR sendreceivebit ; bit 4
    ROR A                     
    JSR sendreceivebit ; bit 5
    ROR A              
    JSR sendreceivebit ; bit 6
    ROR A              
    JSR sendreceivebit ; bit 7    
    ROR A
    ; temporarily keep data here
    TAY 
    ; remove parameter from stack
    PLA
    ; store the data if there is space left
    LDA >numbuffered
    CMP #252
    BEQ receiveandstoredone
    TAX
    INC 
    STA >numbuffered
    TYA
    STA >buffereddata,X
receiveandstoredone
    ; wait until input reaches idle level
    ; (either from stop bit, or when last data bit is high)
    BIT 0                                  
    BPL receiveandstoredone                   
    RTS
    LONGA ON

    ; Send the bit that is given in the carry flag while at the
    ; same time receive the current input into the carry flag. 
    ; The A register needs to be conserved during this.
    ; The caller prepares DBR to point to the IO range.
    ; This subroutine uses 8-bit accu/memory. Calling is done with near JSR.
    ; The other bits for output port are taken from the stack (just above return address).
    ; For real 86c816:
    ;   To get the 115200 baud with a 10 Mhz clock, each bit needs to take about
    ;   87 clocks. With 8 clocks used by the caller, this function is tuned to 
    ;   consume 79 clocks.
    ;   Sampling the input bit is done at about 68 clocks after the call.
    ; For Bernd emulation:
    ;   Speed tuned by measurement
    LONGA OFF
sendreceivebit
    TAY                                                  ; 2   2 
    ; bild output data with carry flag in bit 0,
    ; the rest is taken from stack parameter
    LDA 3,S                                              ; 4   6
    AND #$FE                                             ; 2   8
    ADC #0                                               ; 2  10
    STA 0          ; write to output port                ; 4  14
    ; detect underlying hardware
    CLC                                                  ; 2  16
    XCE                                                  ; 2  18
    BCC true65c816                         ; branch taken: 3  21
berndemulation
    LDX #2
delay1
    DEX                                                  
    BNE delay1
    NOP
    BRA donedelay
true65c816
    LDX #8                                               ; 3  24
delay2
    DEX                                                  ; 2  26 31 36 41 46 51 56 61
    BNE delay2                                          ; 3/2 29 34 39 44 49 54 59 63  
donedelay
    NOP                                                  ; 2  65
    LDA 0          ; fetch input                         ; 4  69
    ASL    ; put input bit into carry flag               ; 2  71
    TYA    ; repair A and return                         ; 2  73
    RTS                                                  ; 6  79
    LONGA ON

; ----------- Convenience function to send a string --------------------    
    ; stack layout:
    ;   SP+1, SP+2, SP+3        return address
    ;   SP+4, SP+5, SP+6, SP+7  pointer to string
~~sendstr
    TSC
    PHD
    TCD
sendstrloop
	LDA	[<4]
    AND #$00FF
    BEQ sendstrend
    PHA
    JSL >~~send
    INC <4
    BNE sendstrloop
    INC <6
    BNE sendstrloop
sendstrend 
    LDA <1
    STA <5
    LDA <2
    STA <6
    PLD
    PLA
    PLA
    RTL 
        
; --- Convenience function to send a decimal representation of a number ----    
    ; stack layout:
    ;   SP+1, SP+2, SP+3        return address
    ;   SP+4, SP+5              unsigned 16 bit number
~~sendnum
    LDX #8    ; digit position in case of value=0
    LDA 4,s
    BEQ sendnumloop
    LDX #-2
skipdigitsloop
    INX
    INX
    CMP >digits,x
    BCC skipdigitsloop    
sendnumloop
    LDY #47  ; one lower than "0"
    LDA 4,s
digitloop
    INY      ; increase digit
    SEC
    SBC >digits,x
    BCS digitloop
    ADC >digits,x
    STA 4,s
    PHX  ; conserve during call
    PHY  
    JSL >~~send
    PLX
    INX
    INX
    LDA >digits,x
    BNE sendnumloop
    LDA 2,s
    STA 4,s
    LDA 1,s
    STA 3,s
    PLA
    RTL
digits:
    DW 10000,1000,100,10,1,0
    
; -------------------- PORT IO functions -------------------
    ; stack layout:
    ;   SP+1, SP+2, SP+3        return address
    ;   SP+4, SP+5              unsigned 16 bit number
~~portout
    SEP #$20
    LONGA OFF
    LDA 4,s
    STA >$400000
    ORA #$03   ; serial expects both its output bits to be high here 
    STA >outportshadow
    REP #$20
    LONGA ON
    LDA 2,s
    STA 4,s
    LDA 1,s
    STA 3,s
    PLA
    RTL
    
    ; stack layout: only return address
~~portin
    SEP #$20
    LONGA OFF
    LDA >$400000
    REP #$20
    LONGA ON
    AND #$00FF
    RTL
    
    
; ---------------- Write to FLASH -------------------------
~~writeflash
; stack frame (accessed via D):  
;   D+1 - D+30                mirrored code    
;   D+51, D+52                previous D 
;   D+53, D+54, D+55          return address
;   D+56, D+57, D+58, D+59    destination address
;   D+60, D+61, D+62, D+63    source address
;   D+64, D+65                length    
    ; set up stack frame
    PHD
    TSC
    SEC
    SBC #50
    TCS
    TCD
    ; transfer program to RAM
    LDX #30-2
transferaccesscode
    LDA >writebytetoflash,X
    STA <1,X
    DEX
    DEX
    BPL transferaccesscode    
    ; compute last byte address of destination
    LDA <64
    DEA      ; length can be considered >=1 here
    CLC
    ADC <56    
    STA <40 ; tmp
    LDA <58
    ADC #0
    STA <42 ; tmp
    ; check if outside bounds
    LDX #0
    LDA <57    
    CMP #$C000
    BCC skipcopyloop    ; destination start is < C00000
    LDA <41
    CMP #$C7F0
    BPL skipcopyloop    ; destination end is >= C7F000   
    ; init counters
    LDX #0
    LDY <64
    BEQ skipcopyloop
    ; use 8-bit accu/memory access during loop
    SEP #$20
    LONGA OFF
writeflashloop    
    DEY
    LDA [<60],Y
    TAX                     
    JSL >executefromstackframe  
    TYX
    BNE writeflashloop
    ; test how many bytes were written correctly    
    LDX #0
    LDY <64 
verifyloop
    INY
    DEY
    BEQ verifydone
    DEY
    LDA [<60],Y
    CMP [<56],Y
    BNE verifyloop
    INX
    BRA verifyloop
verifydone
    ; revert to 16 bit
    REP #$20
    LONGA ON
skipcopyloop
    ; transfer return address to where it is needed
    LDA <53
    STA <63
    LDA <54
    STA <64
    ; repair D, take down stack frame and return    
    LDA <51
    TCD
    TSC 
    CLC
    ADC #62
    TCS
    ; return value was prepared in X
    TXA
    RTL
; This code needs to be mirrored to RAM before executing. 
; parameters:
;     A (low) must be pre-loaded with $AA
;     X value to be written (in lower byte)
;     Y offset target buffer (must be preserved)
; D must point to the stack frame as specified by writeflash. 
; Register widths A/M 8 bit, X/Y 16 bit
; Invocation by far subroutine call
writebytetoflash
    LONGA OFF
    STA >$C05555             ; 4
    LDA #$55                 ; 2
    STA >$C02AAA             ; 4
    LDA #$A0                 ; 2
    STA >$C05555             ; 4
    TXA                      ; 1
    STA [<56],Y              ; 2
waitflashstable
    LDA [<56],Y              ; 2
    CMP [<56],Y              ; 2
    BNE waitflashstable      ; 2
    CMP [<56],Y              ; 2
    BNE waitflashstable      ; 2
    RTL                      ; 1
    LONGA ON                 ; 30 bytes total 

; ---------------- Erase FLASH sector ---------------------
~~eraseflash
; stack frame (accessed via D):  
;   D+1 - D+44                mirrored code    
;   D+51, D+52                previous D 
;   D+53, D+54, D+55          return address
;   D+56, D+57, D+58, D+59    sector address
    ; set up stack frame
    PHD
    TSC
    SEC
    SBC #50
    TCS
    TCD
    ; transfer program to RAM
    LDX #44-2
transfererasecode
    LDA >erasesector,X
    STA <1,X
    DEX
    DEX
    BPL transfererasecode    
    ; round address down to sector boundary
    LDA <56
    AND #$F000
    STA <56
    ; check if sector may be erased
    LDA <57
    CMP #$C000
    BCC aftererase  ; address was < C00000
    CMP #$C7F0      
    BPL aftererase  ; address was >= C7F000    
    ; test if sector actually needs erasing
    LDA #$FFFF
    LDY #4096-2
checkerasedloop
    AND [<56],Y
    DEY
    DEY
    BPL checkerasedloop    
    CMP #$FFFF
    BEQ aftererase
    ; use 8-bit accu/memory access for call
    SEP #$20
    LONGA OFF
    ; execute erase code from RAM
    JSL executefromstackframe  
    ; revert to 16 bit
    REP #$20
    LONGA ON
aftererase
    ; transfer return address to where it is needed
    LDA <53
    STA <57
    LDA <54
    STA <58
    ; repair D, take down stack frame and return    
    LDA <51
    TCD
    TSC 
    CLC
    ADC #56
    TCS
    RTL
; This code needs to be mirrored to RAM before executing. 
; A (low) must be preloaded with $AA
; D must point to the stack frame as specified by eraseflash. 
; Register widths A/M 8 bit, X/Y 16 bit
; Invocation by far subroutine call
erasesector
    LONGA OFF
    STA >$C05555             ; 4
    LDA #$55                 ; 2
    STA >$C02AAA             ; 4
    LDA #$80                 ; 2
    STA >$C05555             ; 4
    LDA #$AA                 ; 2
    STA >$C05555             ; 4
    LDA #$55                 ; 2
    STA >$C02AAA             ; 4
    LDA #$30                 ; 2
    STA [<56]                ; 2
waiterasestable
    LDA [<56]                ; 2
    CMP [<56]                ; 2
    BNE waiterasestable      ; 2
    CMP [<56]                ; 2
    BNE waiterasestable      ; 2
    RTL                      ; 1
    LONGA ON                 ; 43 bytes total 

; ------------------ JUMP TO CODE IN STACK ------------------------------------
    ; Extremely tricky construction to jump to a code that is in the stack frame
    ; at the location D+1 (in bank 0). We prepare a 24-bit pointer
    ; on the stack to be jumped to with use of RTL. Due to a strange quirk in the 
    ; JSL/RTL implementation, the resultant address is actually one higher than what
    ; is taken from the stack, so we will hit D+1 perfectly.
    ; To work correctly, the accu/memory length must be set to 8 bit, and
    ; the accu will also be overwritten.
    LONGA OFF
executefromstackframe
    LDA #0
    PHA
    PHD
    LDA #$AA
    RTL
    LONGA ON              

; -------------------- MEMORY CONFIGURATION QUERY ----------------------------
; User modifyable flash range (everything except boot loader) 
; extends from $C00000 to $C7F000 (508KB)
~~topaddress_flash
    LDX #$00C7
    LDA #$F000
    RTL
; RAM range size depends on detected number or RAM banks
~~topaddress_ram
    LDA >detectedrambanks
    AND #$00FF
    TAX
    LDA #$0000
    RTL

    ENDS
    
; ----------------- Reset code ----------------------------    
RESET SECTION             ; needs to be located at $FFFFF0  
    ; This is a very tricky startup code that needs to work with both
    ; the original 65c816 as well as the Bernd emulator.
    ; The original CPU will come up in emulation mode which has a different
    ; memory map so it will always access bank $FF instead of default 0. 
    ; In this case we must switch to the true ROM bank and turn off emulation.
ORIGINAL65C816            ; FFFFF0
    JMP >TOHIGHBANK  
TOHIGHBANK                ; FFFFF4
    CLC
    XCE
    REP #$30 
    ; Bernd emulation will not use the reset vectors, but will directly jump to this
    ; location with emulation already turned off and all registers in 16bit mode
BERND                     ; FFFFF8
    JMP >~~softreset
    ; The reset vector for the 65C816
RESETVECTOR               ; FFFFFC
    DW $FFF0
    DW 0                  ; padding
    
    ENDS 
    END
    
