c0pperdragon/OS816/(commit log)

2021-04-24 Extract project from the ByteMachine repo.
    [mainboard.kicad_pcb, mainboard.sch]
2021-04-28 Get working reference circuit on a breadboard.
    [mainboard.sch]
2021-05-08 printu16 function Example to compute prime numbers
2021-07-09 Prototype for main function Implement portio in C
2021-07-16 Fixes and adding test suite
    [testint.asm, testint.c]
2021-07-23 Include dumb-terminal version of FROTZ to start getting it to work on OS816 eventually
    [dparams.txt]
2021-07-28 First actually running game on frotz compiled for OS816
    [dparams.txt]
2021-07-30 Fix ANSI sequences and key input handling.
    [fastmem.c, vt100.c]
2021-08-01 Implement heap allocator. Track bug in fread implementation (reading accross bank boundaries)
    [defs.h, fastmem.c, malloc.c, utils.c]
2021-08-02 Replace broken fread implementation.
    [romfile.c, utils.c]
2021-08-02 Speed up the replacement fread a bit
    [utils.c]
2021-08-06 Include games "tube" and "zork"
2021-08-30 Rework file storage system
    [boot.asm, os816.asm, romfile.c]
2021-09-18 Redesign emulation mode memory mapping
    [mainboard.sch]
2021-09-18 Calibrate delay loops to 12MHz clock frequency for native CPU
2021-09-19 Picture of current breadboard assembly
2021-09-24 Start designing a PCB
    [mainboard.kicad_pcb, mainboard.sch]
2021-09-25 More work on PCB design
    [mainboard.kicad_pcb, mainboard.sch]
2021-09-26 Gerber files and BOM
    [mainboard.kicad_pcb, mainboard.sch]
2021-09-26 LED test program also checks RAM
2021-09-28 Fix monitor call command
    [monitor.c]
2021-09-29 Perform soft reset after user program returns
    [boot.asm]
2021-10-03 Browser-based assembler
2021-10-04 Example assembler programs
2021-10-04 Nicer layout for assembler
2021-10-05 Support pin output access that is not disturbed by serial io
2021-10-07 Add second GND pin
    [mainboard.kicad_pcb, mainboard.sch]
2021-10-09 Rework layout for different orientation
    [mainboard.kicad_pcb, mainboard.sch]
2021-10-09 Add input port test to LED animation example
2021-10-10 Change clock frequency to 10MHz for simpler calculations and cheaper parts.
    [mainboard.kicad_pcb, mainboard.sch]
2021-10-10 Tweak parts values and types
    [mainboard.sch]
2021-10-10 Copy schema to layout
    [mainboard.kicad_pcb]
2021-10-17 Gerber files rev. 2
    [mainboard.kicad_pcb]
2021-10-19 Change memory map to prepare for simpler MMU circuit
2021-10-23 Simpler MMU and smaller PCB (4 layer)
    [mainboard.kicad_pcb, mainboard.sch]
2021-10-23 Update BOM
2021-11-14 Comments in he BOM
2021-12-18 More reliable reset circuit
    [mainboard.sch]
2022-03-18 Provide all 8 address lines on the latch outputs.
    [mainboard.kicad_pcb, mainboard.sch]
2022-05-01 Expose high address bits for possible expansion
    [mainboard.kicad_pcb, mainboard.sch]
2024-10-25 Add higher addresslines for memory and flash Add auxilary port
    [mainboard.kicad_pcb, mainboard.kicad_sch]
2024-10-26 Add control signals for FLASH to allow 8MB (needs very special wiring)
    [mainboard.kicad_pcb, mainboard.kicad_sch]
2024-10-26 Remove extra signals from flash socket to not confuse the matter too much.
    [mainboard.kicad_pcb, mainboard.kicad_sch]
2024-10-28 Again add AUXRD and AUXWR to the FLASH socket for more expansion possibilties.
    [mainboard.kicad_pcb, mainboard.kicad_sch]
2024-12-08 Make RAM more expandable
    [mainboard.kicad_pcb, mainboard.kicad_sch]
2024-12-09 Change second RAM address connector (again)
    [mainboard.kicad_pcb, mainboard.kicad_sch]
2024-12-09 2/4M memory upgrade
    [ramboard.kicad_pcb, ramboard.kicad_sch]
2024-12-10 Redesign AUX port for use with breadboard
    [mainboard.kicad_pcb, mainboard.kicad_sch]
2025-03-02 Simplify RAM interface
    [mainboard.kicad_pcb, mainboard.kicad_sch]
2025-03-05 Make 20-pin aux connector and 3 extra address pins for RAM
    [mainboard.kicad_pcb, mainboard.kicad_sch]
2025-03-06 Adjust silk screen
    [mainboard.kicad_pcb]
2025-03-06 Fix silkscreen
    [mainboard.kicad_pcb]
2025-03-06 Ram board with a single RAM IC
    [ramboard.kicad_pcb, ramboard.kicad_sch]
2025-03-08 Implement framework to organize devices.
2025-09-30 Doc for SDcard interface
    [mkfs.xlsx]
2025-10-03 Recompile examples. Restructure doc.
    [mkfs.xlsx]
2025-10-06 Fix pin connections
2026-02-10 Update to newer KiCAD. Add second 5V connector and remove one GND.
    [mainboard.kicad_pcb, mainboard.kicad_sch]
2026-02-11 Make 4MB ram board
    [ramboard.kicad_pcb, ramboard.kicad_sch]
2026-05-09 Fix chip select inputs
    [ramboard.kicad_pcb, ramboard.kicad_sch]
2026-07-31 Fix missing traces for upper 2MB in RAM board
    [ramboard.kicad_pcb, ramboard.kicad_sch]
2026-10-04 Can read total capacity info from SD and SDHC cards.
