c0pperdragon/OS816/(notices)

Notices in the files:
examples/frotz/src/files.c:
Frotz is free software; you can redistribute it and/or modify
it under the terms of the GNU General Public License as published by
the Free Software Foundation; either version 2 of the License, or
(at your option) any later version.
mainboard/mainboard.kicad_pcb:
github.com/c0pperdragon/OS816 © 2025 Reinhard Grafl
